RipanRenaldi25/TA-WSN/Node Sensor/Node Sensor.kicad_pcb

## KiCad design KiCad/DesignSchematic/DesignSchematic.kicad_sch

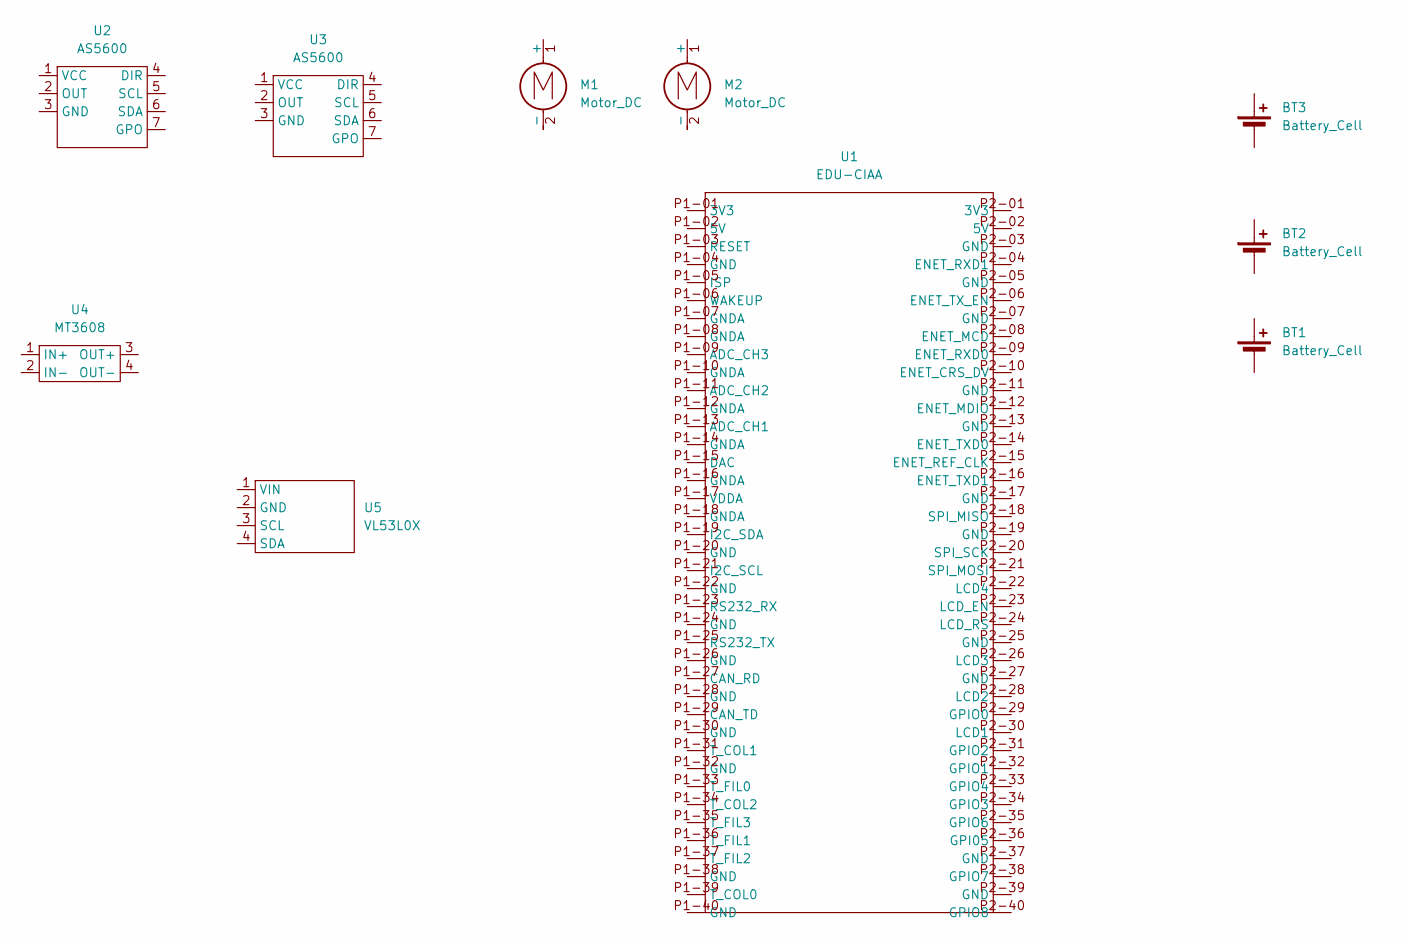
[picture p1: schematic DesignSchematic.kicad_sch]

Parts:
BT1, BT2, BT3: Battery_Cell
M1, M2: Motor_DC
U1: EDU-CIAA
U2, U3: AS5600
U4: MT3608
U5: VL53L0X
