RipanRenaldi25/TA-WSN/(commit log)

2026-06-14 feat(sink-node): Make sure that relay is active properly, details: - User can retrieve actuator status that subscribe to topic gh01/node255/status/+ - User can control actuator via MQTT broker that p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
    [node_sensor_v1.ino, node_sensor_v2.ino, sink_node_v1.ino, sink_node_v2.ino]
2026-06-14 feat(threshold): Make sure that threshold is trigger actuator
2026-06-14 fix(manage-actuator): fix login when managin the actuator based on threshold
    [sink_node_v2.ino]
2026-06-16 feat(actuator): Make sure that actuator work properly on manual and automatic with Active low trigger
2026-07-15 feat(sink-node): Multiple Thread to manage storing sd card on offline mode
2026-08-19 feat(multi-thread): Add network management task to handle all related network task
